Bjoshua25/Smart-Pumping-Machine-Controller/automatic_pump_schematic/Project_Description.docx

RF BASED AUTOMATIC WATER PUMP CONTROLLER SOLUTION FOR EFFICIENT WATER MANAGEMENT IN NIGERIA

Table 1.0: System Operation Summary

Sensory Device | Controller Device
System Start up | System Start up
Sense water level via float switches | Enter a default mode of not pumping
Send a short message of the water level via LoRa | Receive an incoming message from the Sensory device
Receive an acknowledgement message from the controller within 200 ms | Send acknowledge message that the received command has been implemented.
Based on received message from controller, turn ON water pump indicator. | Trigger the relay for the water pump based on command received
If no acknowledgement message is received, listen 2 more times for an incoming message before going back to sleep mode. | Send an acknowledgement message within 2 ms of receiving water level state from the sensory device.
Send an heartbeat message of the current water level state every 15 minutes in order to catch up with the controller | Continue or discontinue ongoing control task based on the 15 minutes heartbeat message from sensory device
