Bjoshua25/Smart-Pumping-Machine-Controller/images/LoRa_module.jpg

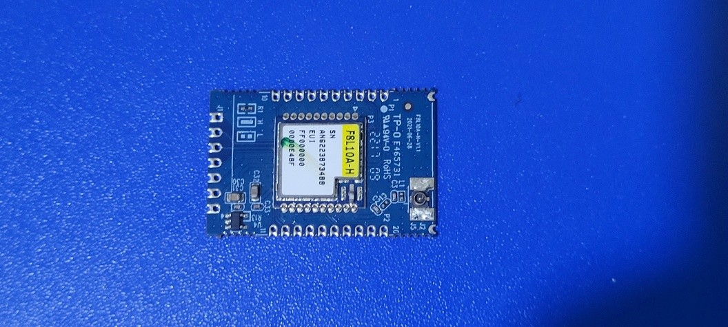
images/LoRa_module.jpg
