Bjoshua25/Smart-Pumping-Machine-Controller/images/receiver_pcb.jpg

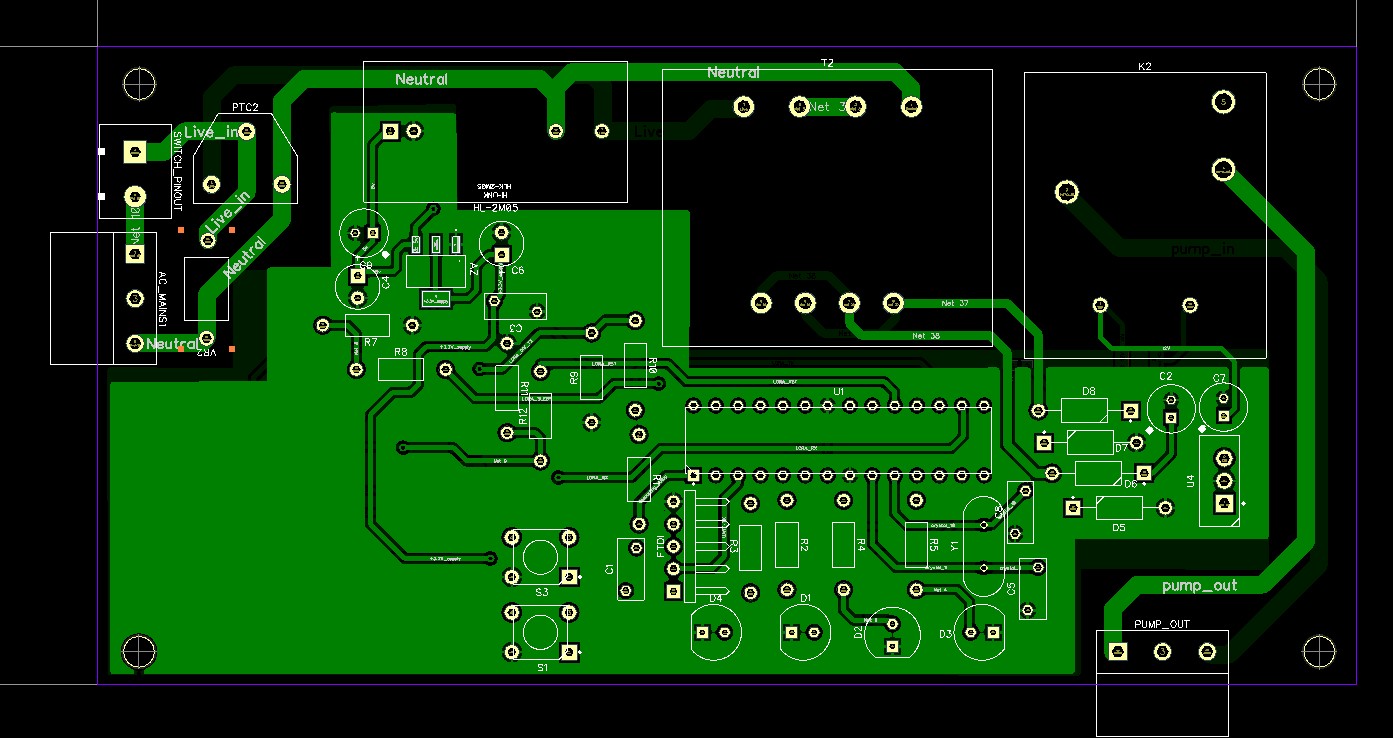
images/receiver_pcb.jpg
