Bjoshua25/Smart-Pumping-Machine-Controller/images/transmitter_pcb.jpg

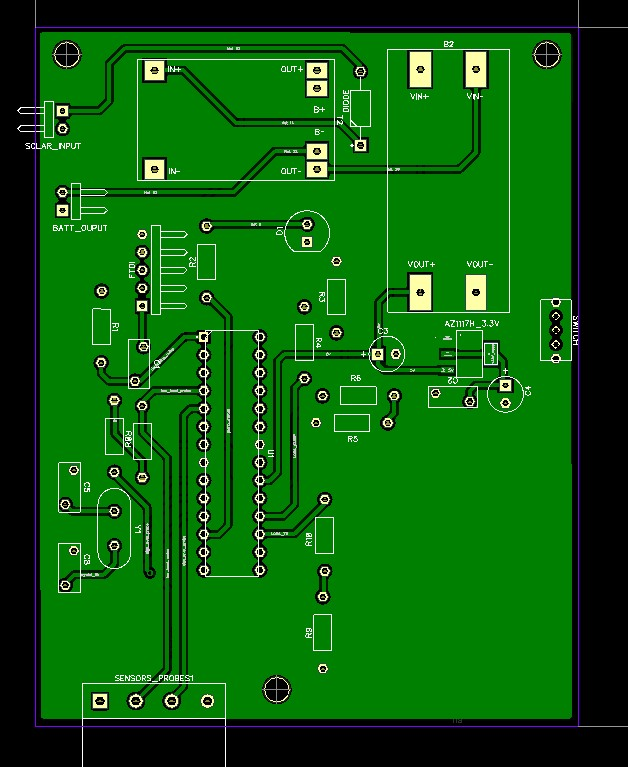
images/transmitter_pcb.jpg
