Bjoshua25/Smart-Pumping-Machine-Controller/images/water_level_float_sensor.jpg

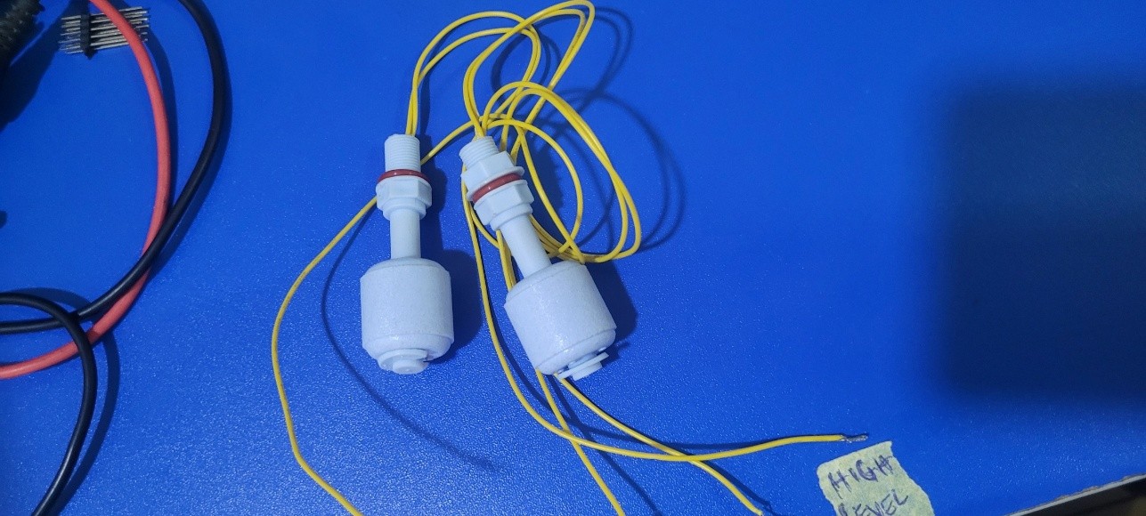
images/water_level_float_sensor.jpg
