Bjoshua25/Smart-Pumping-Machine-Controller/(list of files, drawings)

Other design files:
automatic_pump_schematic/Automatic_pump_board_one (IDAS).dip
automatic_pump_schematic/Automatic_pump_board_one.dip
automatic_pump_schematic/Automatic_pump_board_two (IDAS).dip
automatic_pump_schematic/Automatic_pump_board_two.dip
automatic_pump_schematic/Automatic_pump_controller_(final).dch
automatic_pump_schematic/automatic_pumping_machine_control.pdsprj
automatic_pump_schematic/Automatic_water_tank_sensor_(final).dch
