Bjoshua25/Smart-Pumping-Machine-Controller/(commit log)

2025-08-31 inital commit: contains arduino ide code and proteus simulation
    [automatic_pumping_machine_control.pdsprj]
2025-08-31 Setting up LoRa for Pin-to-Pin communication
2025-09-12 Further Progress on Transmitting Pump and water level status to a receiver
2025-09-15 updated the receiver firmware to handle errors and corrupt display on the LCD
    [receiver.ino, transmitter.ino]
2025-09-18 transmitter and receiver node firmware with integration of manual button for remote switch
2025-10-27 Added schematics and final PCB designs for the RF automatic water pump controller
    [AZ1117H-3.3TRE1.STEP, Automatic_pump_board_one (IDAS).dip, Automatic_pump_board_one.dip, Automatic_pump_board_two (IDAS).dip, Automatic_pump_board_two.dip, Automatic_pump_controller_(final).dch, Automatic_water_tank_sensor_(final).dch, BOM.csv]
2025-10-27 Revise README for clarity on project scope
    Updated project title and expanded description to clarify the use of Radio Frequency and the roles of the Automatic Pump Controller and Automatic Water Sensing devices.
2025-10-27 schematic image
2025-10-27 Expand README with APC and AWLS device details
    Added detailed sections for APC and AWLS device PCBs, including images and components used.
2026-01-13 Adjusted the firmware to indicate pump status on the sensing device
2026-05-04 Adjusted and updated the repo
    [AZ1117H-3.3TRE1.STEP, Automatic_pump_board_one.dip, BOM.csv, BOM_1.csv, BOM_2.csv, PPTC041LFBN-RC--3DModel-STEP-269445.STEP, V510LT80CPX10.STEP, automatic_pumping_machine_control.pdsprj]
2026-05-07 deleted some un-needed Diptrace schematic library
2026-05-07 Include readme file for schematic folder
